damian-EE/motor-control-validation-platform/media/run_20261022_030916_timeseries.png

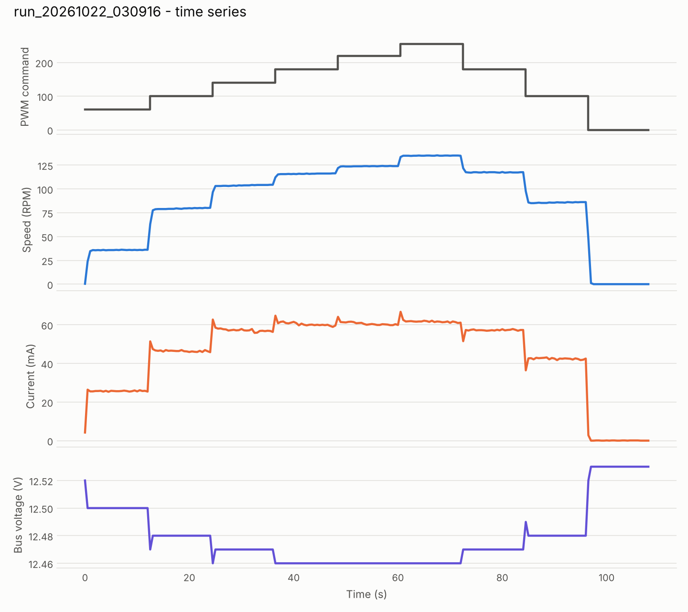
media/run_20261022_030916_timeseries.png
