damian-EE/motor-control-validation-platform/media/run_20261022_031231_timeseries.png

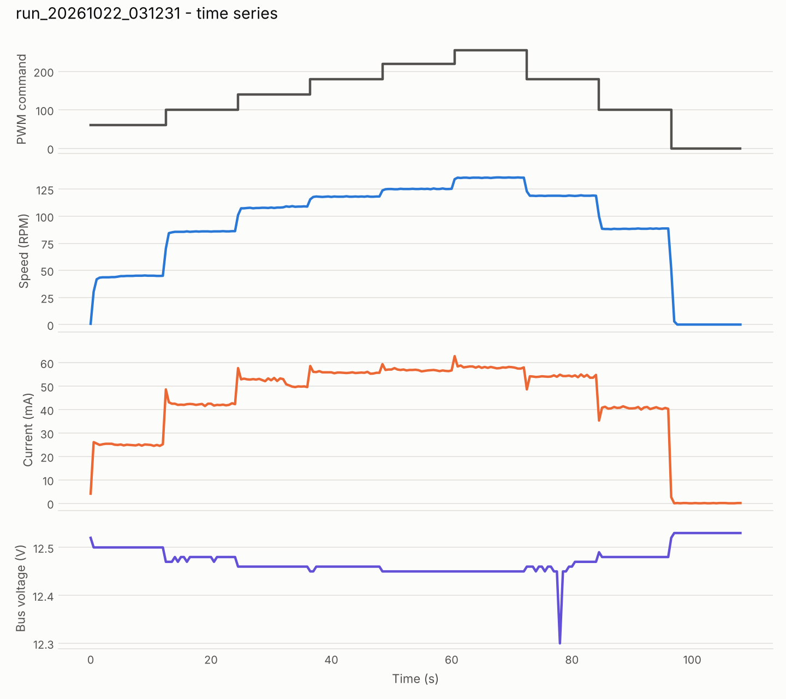
media/run_20261022_031231_timeseries.png
