damian-EE/motor-control-validation-platform/test_results/run_20261022_030916_summary.csv

pwm | start_s | samples | rpm_mean | rpm_std | current_mA_mean | voltage_V_mean | power_W_mean
60 | 0.0 | 25 | 35.96 | 0.15 | 25.69 | 12.5 | 0.32
100 | 12.5 | 24 | 79.81 | 0.31 | 46.23 | 12.48 | 0.58
140 | 24.5 | 24 | 104.12 | 0.22 | 56.76 | 12.47 | 0.71
180 | 36.5 | 24 | 116.17 | 0.17 | 59.76 | 12.46 | 0.74
220 | 48.5 | 24 | 124.0 | 0.12 | 60.08 | 12.46 | 0.75
255 | 60.5 | 24 | 135.02 | 0.13 | 61.44 | 12.46 | 0.77
180 | 72.5 | 24 | 117.41 | 0.22 | 57.31 | 12.47 | 0.71
100 | 84.5 | 24 | 86.0 | 0.21 | 42.26 | 12.48 | 0.53
0 | 96.5 | 24 | 0.0 | 0.0 | 0.05 | 12.53 | 0.0
