damian-EE/motor-control-validation-platform/test_results/run_20261022_031231_summary.csv

pwm | start_s | samples | rpm_mean | rpm_std | current_mA_mean | voltage_V_mean | power_W_mean
60 | 0.0 | 25 | 45.03 | 0.13 | 24.86 | 12.5 | 0.31
100 | 12.5 | 24 | 86.03 | 0.12 | 42.12 | 12.48 | 0.53
140 | 24.5 | 24 | 108.62 | 0.54 | 50.97 | 12.46 | 0.64
180 | 36.5 | 24 | 118.13 | 0.16 | 55.68 | 12.46 | 0.69
220 | 48.5 | 24 | 125.22 | 0.21 | 56.62 | 12.45 | 0.7
255 | 60.5 | 24 | 135.64 | 0.14 | 57.88 | 12.45 | 0.72
180 | 72.5 | 24 | 118.92 | 0.18 | 54.28 | 12.47 | 0.68
100 | 84.5 | 24 | 88.55 | 0.16 | 40.6 | 12.48 | 0.51
0 | 96.5 | 24 | 0.0 | 0.0 | 0.05 | 12.53 | 0.0
