damian-EE/motor-control-validation-platform/test_results/run_20261022_031935_summary.csv

pwm | start_s | samples | rpm_mean | rpm_std | current_mA_mean | voltage_V_mean | power_W_mean
60 | 0.0 | 25 | 45.8 | 0.37 | 24.73 | 12.5 | 0.31
100 | 12.5 | 24 | 85.97 | 0.17 | 42.11 | 12.48 | 0.53
140 | 24.5 | 24 | 108.49 | 0.59 | 51.03 | 12.47 | 0.64
180 | 36.5 | 24 | 117.92 | 0.23 | 55.65 | 12.46 | 0.69
220 | 48.5 | 24 | 124.95 | 0.19 | 57.12 | 12.46 | 0.71
255 | 60.5 | 24 | 135.34 | 0.22 | 58.28 | 12.46 | 0.73
180 | 72.5 | 24 | 118.44 | 0.17 | 54.56 | 12.46 | 0.68
100 | 84.5 | 24 | 87.07 | 0.3 | 41.28 | 12.48 | 0.52
0 | 96.5 | 24 | 0.0 | 0.0 | 0.04 | 12.53 | 0.0
