damian-EE/motor-control-validation-platform/test_results/run_20261022_030916.csv

time_ms | pwm | rpm | current_mA | voltage_V
501.0 | 60.0 | 0.4 | 4.2 | 12.52
1001.0 | 60.0 | 23.8 | 26.4 | 12.5
1501.0 | 60.0 | 34.7 | 25.5 | 12.5
2001.0 | 60.0 | 35.8 | 25.5 | 12.5
2501.0 | 60.0 | 35.6 | 25.7 | 12.5
3001.0 | 60.0 | 35.8 | 25.7 | 12.5
3501.0 | 60.0 | 35.6 | 25.8 | 12.5
4001.0 | 60.0 | 36.0 | 25.4 | 12.5
4501.0 | 60.0 | 35.6 | 25.8 | 12.5
5001.0 | 60.0 | 35.8 | 25.3 | 12.5
5501.0 | 60.0 | 35.8 | 25.8 | 12.5
6001.0 | 60.0 | 35.8 | 25.7 | 12.5
6501.0 | 60.0 | 36.0 | 25.6 | 12.5
7001.0 | 60.0 | 35.8 | 25.6 | 12.5
7501.0 | 60.0 | 36.2 | 25.7 | 12.5
8001.0 | 60.0 | 36.0 | 25.9 | 12.5
8501.0 | 60.0 | 35.8 | 25.7 | 12.5
9001.0 | 60.0 | 36.0 | 25.4 | 12.5
9501.0 | 60.0 | 35.8 | 25.6 | 12.5
10001.0 | 60.0 | 36.0 | 26.0 | 12.5
10501.0 | 60.0 | 35.8 | 25.5 | 12.5
11001.0 | 60.0 | 36.0 | 26.1 | 12.5
11501.0 | 60.0 | 35.8 | 25.7 | 12.5
12001.0 | 60.0 | 36.2 | 25.8 | 12.5
12502.0 | 60.0 | 36.1 | 25.4 | 12.5
13002.0 | 100.0 | 63.1 | 51.4 | 12.47
13502.0 | 100.0 | 77.6 | 47.4 | 12.48
14002.0 | 100.0 | 78.7 | 46.7 | 12.48
14502.0 | 100.0 | 78.9 | 46.5 | 12.48
15002.0 | 100.0 | 78.9 | 46.7 | 12.48
15502.0 | 100.0 | 78.9 | 46.1 | 12.48
16002.0 | 100.0 | 78.9 | 46.9 | 12.48
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
