damian-EE/motor-control-validation-platform/test_results/run_20261022_031231.csv

time_ms | pwm | rpm | current_mA | voltage_V
501.0 | 60.0 | 0.7 | 4.1 | 12.52
1001.0 | 60.0 | 30.4 | 26.1 | 12.5
1501.0 | 60.0 | 41.8 | 25.5 | 12.5
2001.0 | 60.0 | 43.3 | 24.9 | 12.5
2501.0 | 60.0 | 43.6 | 25.2 | 12.5
3001.0 | 60.0 | 43.6 | 25.4 | 12.5
3501.0 | 60.0 | 43.6 | 25.4 | 12.5
4001.0 | 60.0 | 43.8 | 25.4 | 12.5
4501.0 | 60.0 | 43.8 | 25.0 | 12.5
5001.0 | 60.0 | 44.2 | 24.9 | 12.5
5501.0 | 60.0 | 44.7 | 25.1 | 12.5
6001.0 | 60.0 | 44.7 | 24.7 | 12.5
6501.0 | 60.0 | 44.9 | 25.0 | 12.5
7001.0 | 60.0 | 44.9 | 24.9 | 12.5
7501.0 | 60.0 | 44.9 | 24.8 | 12.5
8001.0 | 60.0 | 45.1 | 24.7 | 12.5
8501.0 | 60.0 | 45.1 | 25.1 | 12.5
9001.0 | 60.0 | 45.1 | 24.6 | 12.5
9501.0 | 60.0 | 45.3 | 25.1 | 12.5
10001.0 | 60.0 | 45.1 | 25.0 | 12.5
10501.0 | 60.0 | 45.1 | 24.9 | 12.5
11001.0 | 60.0 | 45.1 | 24.5 | 12.5
11501.0 | 60.0 | 44.9 | 24.9 | 12.5
12001.0 | 60.0 | 44.9 | 24.5 | 12.5
12502.0 | 60.0 | 45.0 | 25.2 | 12.5
13002.0 | 100.0 | 70.2 | 48.6 | 12.47
13502.0 | 100.0 | 84.4 | 43.1 | 12.47
14002.0 | 100.0 | 85.1 | 42.5 | 12.47
14502.0 | 100.0 | 85.6 | 42.5 | 12.48
15002.0 | 100.0 | 85.6 | 42.0 | 12.47
15502.0 | 100.0 | 85.6 | 42.1 | 12.48
16002.0 | 100.0 | 85.6 | 42.0 | 12.48
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
