damian-EE/motor-control-validation-platform/test_results/run_20261022_031935.csv

time_ms | pwm | rpm | current_mA | voltage_V
501.0 | 60.0 | 0.4 | 3.9 | 12.52
1001.0 | 60.0 | 29.3 | 25.9 | 12.5
1501.0 | 60.0 | 42.2 | 25.3 | 12.5
2001.0 | 60.0 | 43.8 | 24.6 | 12.5
2501.0 | 60.0 | 44.7 | 24.9 | 12.5
3001.0 | 60.0 | 44.7 | 24.5 | 12.5
3501.0 | 60.0 | 44.9 | 24.6 | 12.5
4001.0 | 60.0 | 44.9 | 24.8 | 12.5
4501.0 | 60.0 | 44.7 | 25.0 | 12.5
5001.0 | 60.0 | 44.9 | 25.1 | 12.5
5501.0 | 60.0 | 44.9 | 24.6 | 12.5
6001.0 | 60.0 | 45.3 | 24.9 | 12.5
6501.0 | 60.0 | 45.1 | 24.5 | 12.5
7001.0 | 60.0 | 45.3 | 24.8 | 12.5
7501.0 | 60.0 | 45.6 | 24.6 | 12.5
8001.0 | 60.0 | 45.3 | 25.0 | 12.5
8501.0 | 60.0 | 45.8 | 24.8 | 12.5
9001.0 | 60.0 | 46.0 | 25.1 | 12.5
9501.0 | 60.0 | 45.8 | 24.4 | 12.5
10001.0 | 60.0 | 46.0 | 24.8 | 12.5
10501.0 | 60.0 | 46.0 | 24.8 | 12.5
11001.0 | 60.0 | 46.2 | 24.8 | 12.5
11501.0 | 60.0 | 46.0 | 24.7 | 12.5
12001.0 | 60.0 | 46.2 | 24.4 | 12.5
12502.0 | 60.0 | 46.1 | 24.8 | 12.5
13002.0 | 100.0 | 71.1 | 48.3 | 12.47
13502.0 | 100.0 | 84.9 | 43.1 | 12.48
14002.0 | 100.0 | 85.8 | 42.2 | 12.48
14502.0 | 100.0 | 86.0 | 42.4 | 12.48
15002.0 | 100.0 | 85.8 | 42.7 | 12.48
15502.0 | 100.0 | 86.0 | 41.8 | 12.48
16002.0 | 100.0 | 85.8 | 41.9 | 12.48
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
