damian-EE/motor-control-validation-platform/hardware/schematic.pdf

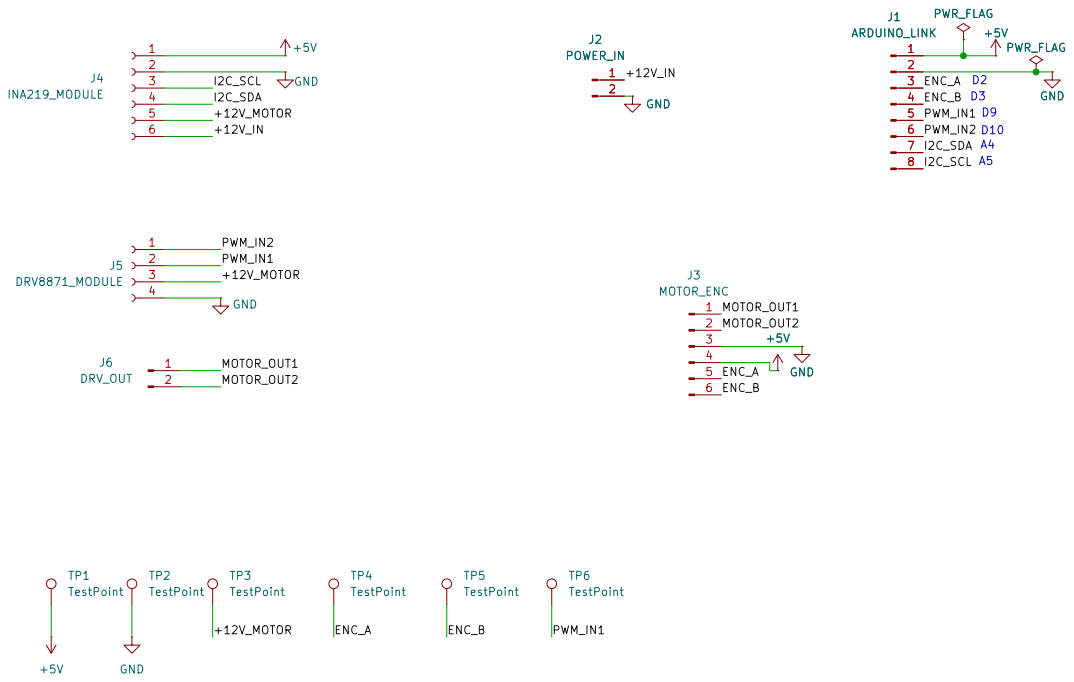
[picture p8: page 1]

Sheet: /
File: motor-validation-board.kicad_sch
Title: Motor Control & Validation Board

Size: A4 | Rev: 1.0
KiCad E.D.A. 10.0.6 | Id: 1/1
