damian-EE/motor-control-validation-platform/hardware/kicad/motor-validation-board.kicad_pcb

## KiCad design hardware/kicad/motor-validation-board.kicad_pcb (2026-10-22)

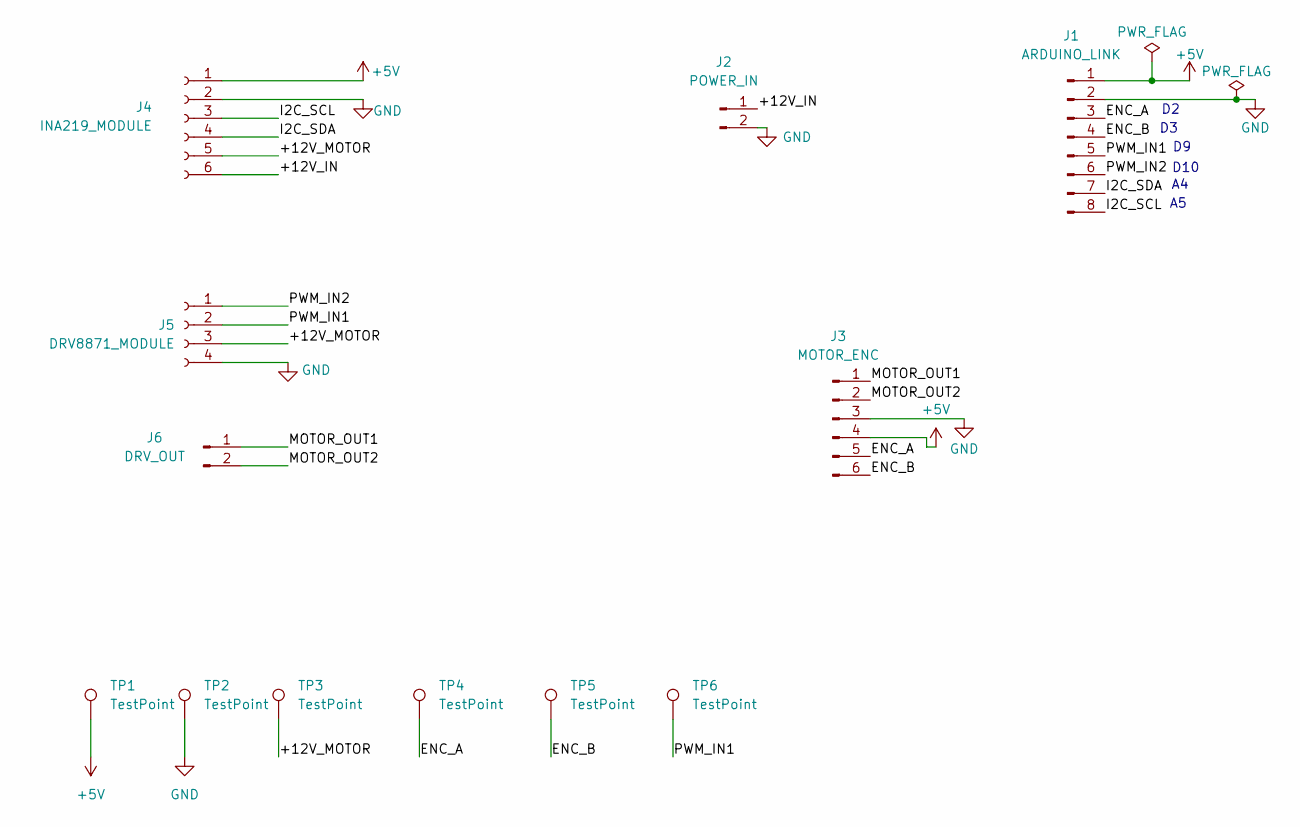
[picture p9: schematic motor-validation-board.kicad_sch, Motor Control & Validation Board]

Parts:
J1: ARDUINO_LINK; PinHeader_1x08_P2.54mm_Vertical
J2: POWER_IN; TerminalBlock_Phoenix_MKDS-1,5-2-5.08_1x02_P5.08mm_Horizont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
J3: MOTOR_ENC; PinHeader_1x06_P2.54mm_Vertical
J4: INA219_MODULE; PinSocket_1x06_P2.54mm_Vertical
J5: DRV8871_MODULE; PinSocket_1x04_P2.54mm_Vertical
J6: DRV_OUT; PinHeader_1x02_P2.54mm_Vertical
TP1, TP2, TP3, TP4, TP5, TP6: TestPoint; TestPoint_THTPad_D2.0mm_Drill1.0mm

Connections:
+5V: J1.1, J3.4, J4.1, TP1.1 (1_1)
/+12V_IN: J2.1, J4.6
/+12V_MOTOR: J4.5, J5.3, TP3.1 (1_1)
/ENC_A: J1.3, J3.5, TP4.1 (1_1)
/ENC_B: J1.4, J3.6, TP5.1 (1_1)
/I2C_SCL: J1.8, J4.3
/I2C_SDA: J1.7, J4.4
/MOTOR_OUT1: J3.1, J6.1
/MOTOR_OUT2: J3.2, J6.2
/PWM_IN1: J1.5, J5.2, TP6.1 (1_1)
/PWM_IN2: J1.6, J5.1
GND: J1.2, J2.2, J3.3, J4.2, J5.4, TP2.1 (1_1)

Notes on the sheet:
D10

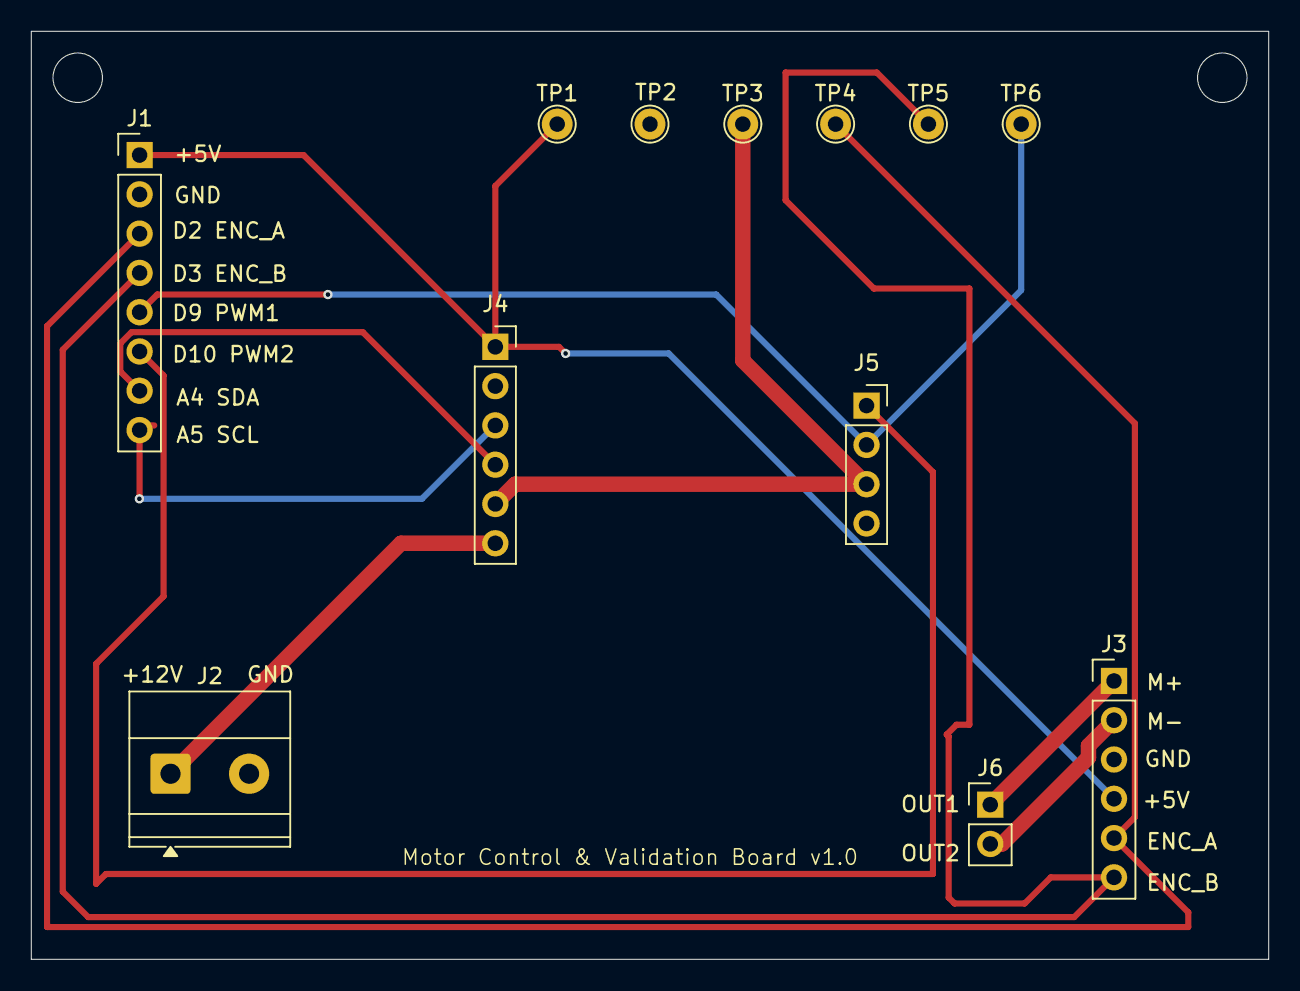
[picture p10: board motor-validation-board.kicad_pcb from above]

Board: 2 copper layers, 80.0 x 60.0 mm, 12 parts (0 on the bottom side), 12 nets.
