damian-EE/motor-control-validation-platform/(commit log)

2026-10-22 Motor control & validation platform: firmware, logger, test data, KiCad project
    [bom.csv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]
2026-10-22 Reframe README around PCB design, disclose AI-written code
